micromouseuci/micromouse-kit/README.md

Starting new README for the BluePill Version thats work in progress!
