micromouseuci/micromouse-kit/3d_printed_parts/Motor Offset.SLDPRT

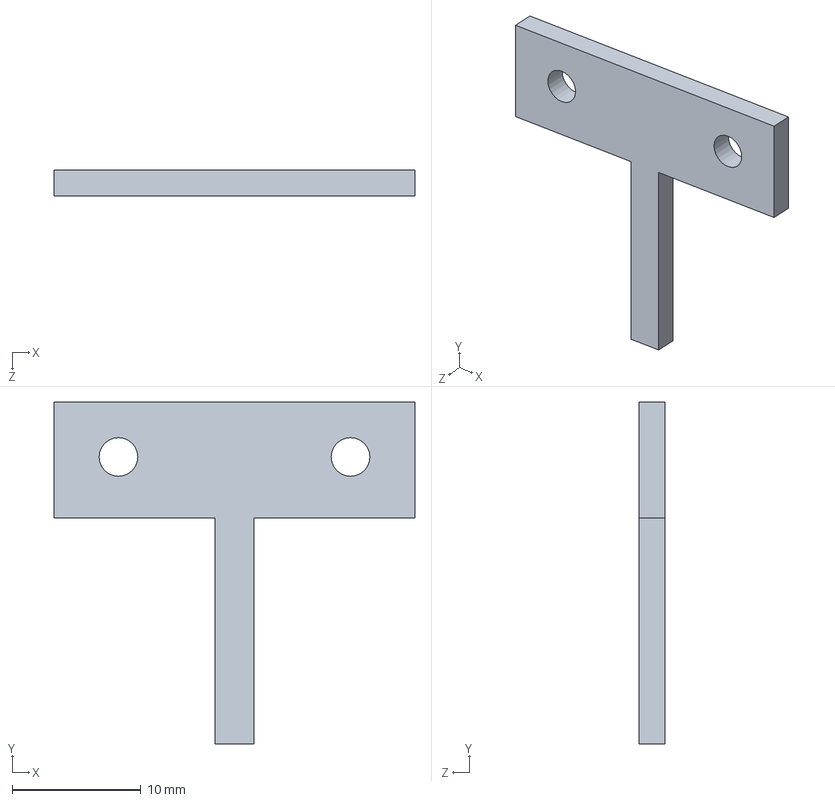
[picture p1: CAD file, 2021-07-19]
3d_printed_parts/Motor Offset.SLDPRT
28.0 x 26.5 x 2.00 mm
