micromouseuci/micromouse-kit/3d_printed_parts/27 Rubber Band Wheel.SLDPRT

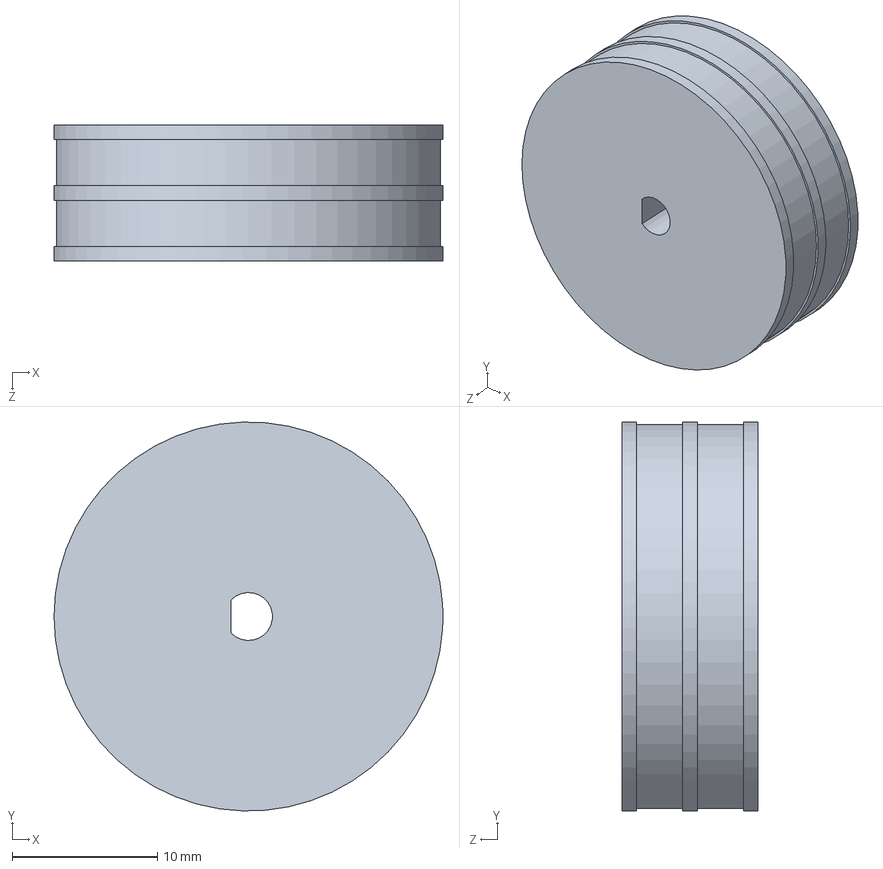
[picture p2: CAD file, 2021-07-19]
3d_printed_parts/27 Rubber Band Wheel.SLDPRT
26.8 x 26.7 x 9.35 mm
