micromouseuci/micromouse-kit/3d_printed_parts/Mouse Skates.SLDPRT

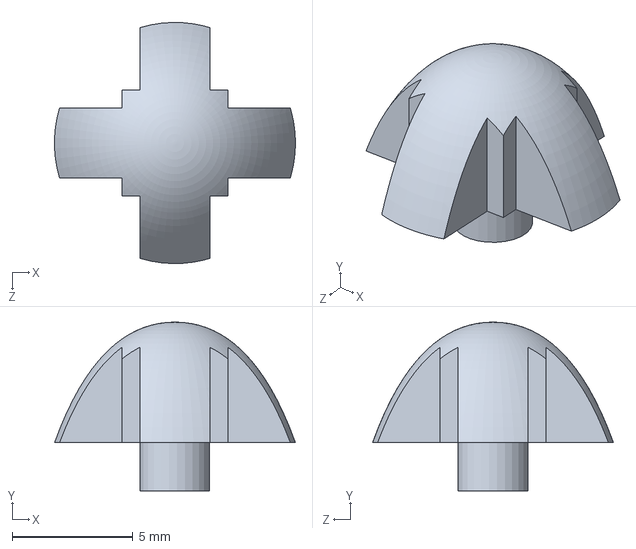
[picture p3: CAD file, 2021-07-19]
3d_printed_parts/Mouse Skates.SLDPRT
10.00 x 7.00 x 10.00 mm
