micromouseuci/micromouse-kit/3d_printed_parts/flat skates.SLDPRT

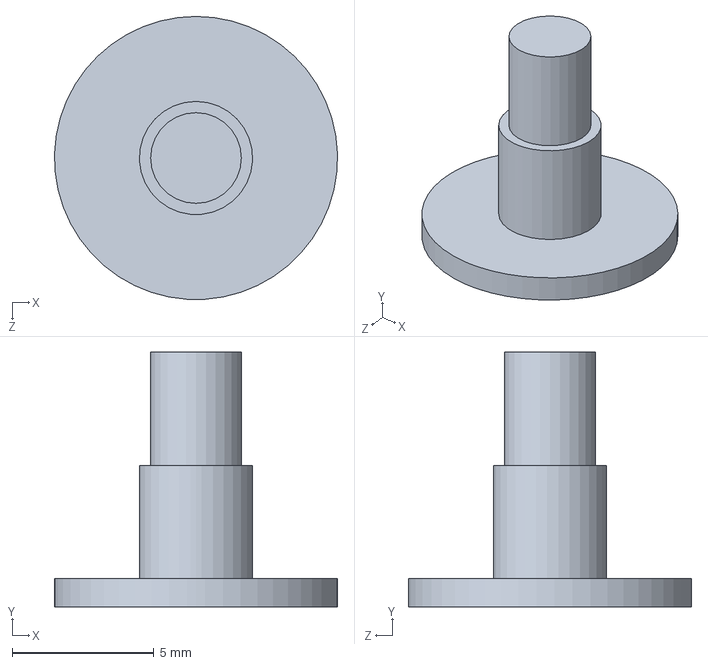
[picture p4: CAD file, 2021-07-19]
3d_printed_parts/flat skates.SLDPRT
9.99 x 9.00 x 10.0 mm
