micromouseuci/micromouse-kit/(list of files, cad)

Other CAD files:
3d_printed_parts/27 Rubber Band Wheel.STL
3d_printed_parts/Mouse Skates.STL
3d_printed_parts/flat skates.STL
