micromouseuci/micromouse-kit/mouse_v2_PAIN copy.kicad_pcb

## KiCad design mouse_v2_PAIN copy.kicad_pcb (2022-06-02, an earlier design)

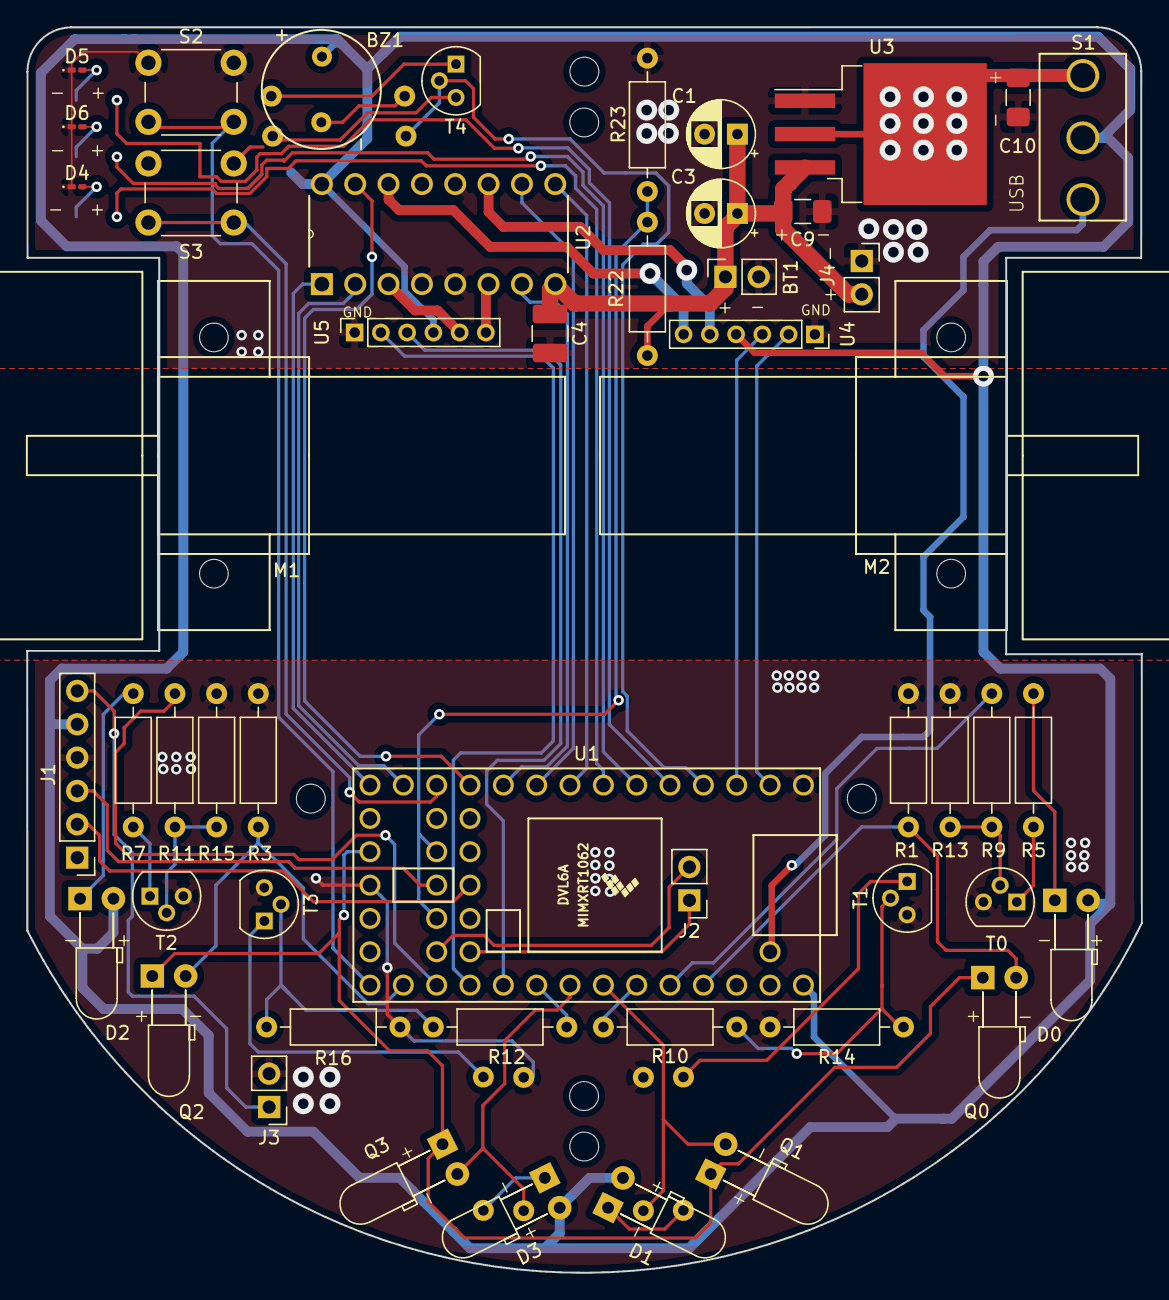
[picture p8: board mouse_v2_PAIN copy.kicad_pcb from above]

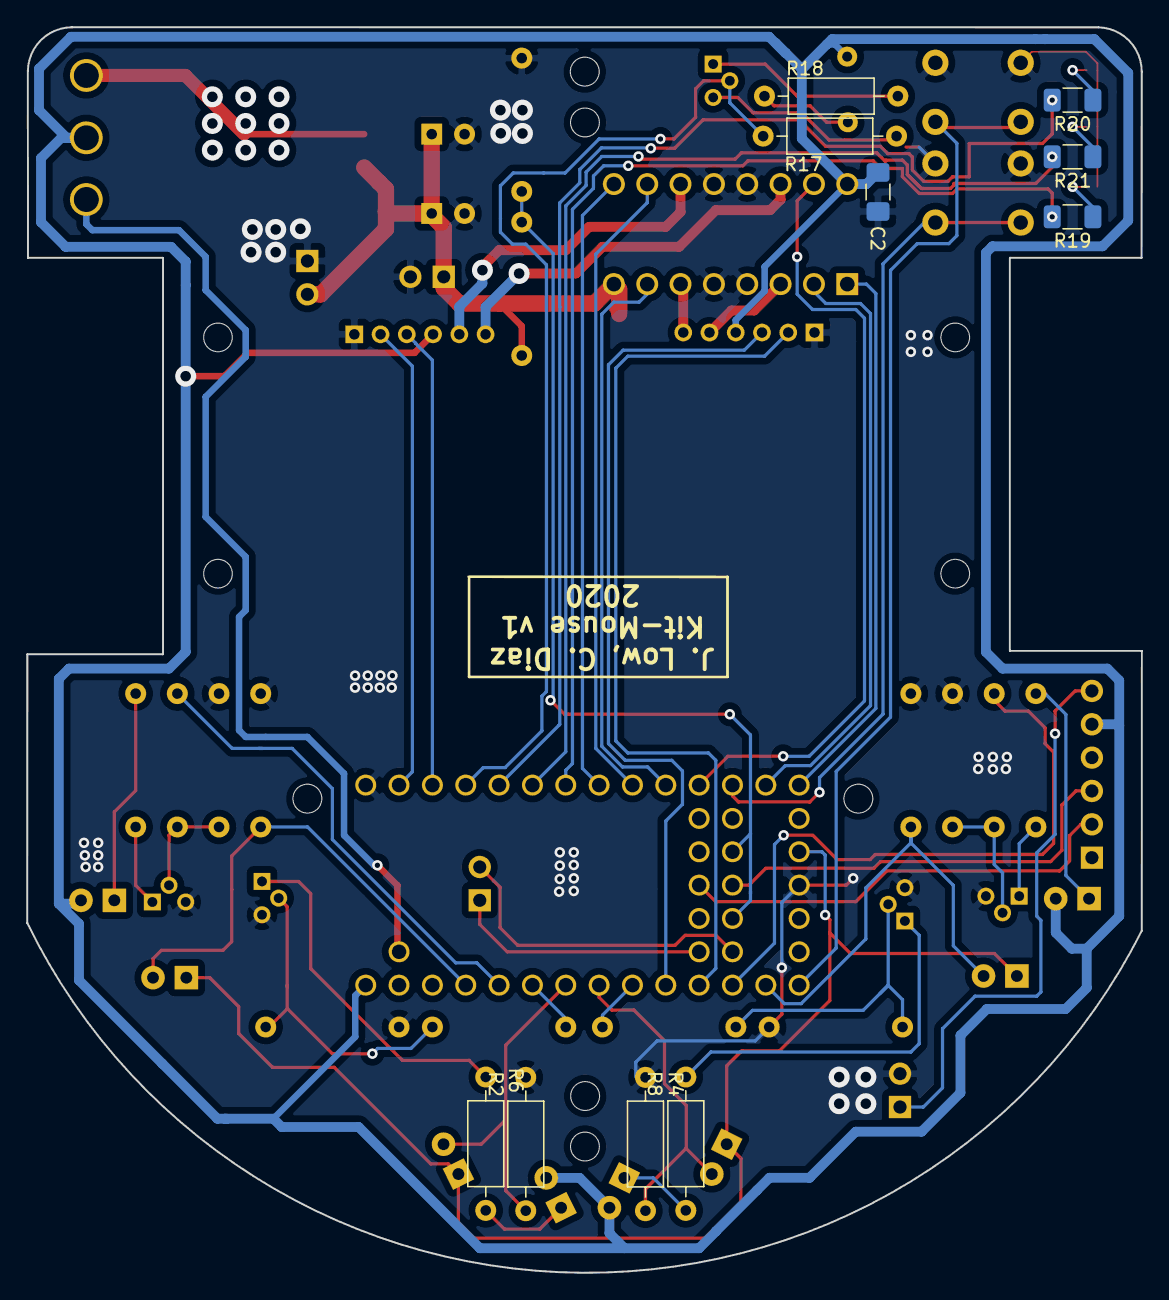
[picture p9: board mouse_v2_PAIN copy.kicad_pcb from below]

Board: 2 copper layers, 84.9 x 94.9 mm, 67 parts (10 on the bottom side), 58 nets.

Parts:
BT1: Battery_Cell; PinSocket_1x02_P2.54mm_Vertical
BZ1: Buzzer; 9x5.5mm Buzzer
C1, C3: 100uF; CP_Radial_D5.0mm_P2.50mm
C2: 0.1uF; C_1206_3216Metric_Pad1.42x1.75mm_HandSolder
C4: 1uF; C_1210_3225Metric_Pad1.42x2.65mm_HandSolder
C9: 10uF; C_1206_3216Metric_Pad1.42x1.75mm_HandSolder
C10: 10uF(Tantalum); C_1206_3216Metric_Pad1.42x1.75mm_HandSolder
D0, D1, D2, D3: SFH4545; LED_D3.0mm_Horizontal_O3.81mm_Z2.0mm
D4, D5, D6: LED; LED_0201_0603Metric_Pad0.64x0.40mm_HandSolder
J1: Conn_01x06_Female; PinHeader_1x06_P2.54mm_Vertical
J2: Conn_01x02_Female; PinHeader_1x02_P2.54mm_Vertical
J3: Conn_01x02_Male; PinHeader_1x02_P2.54mm_Vertical
J4: I2C_Conn; PinSocket_1x02_P2.54mm_Vertical
M1, M2: Motor_DC; Motor_mouse
MH1, MH2: M3; MountingHole_2.2mm_M2
Q0, Q1, Q2, Q3: Q_Photo_NPN; LED_D3.0mm_Horizontal_O3.81mm_Z2.0mm
R1, R2, R3, R4: 1.8k; R_Axial_DIN0207_L6.3mm_D2.5mm_P10.16mm_Horizontal
R5, R6, R7, R8: 35; R_Axial_DIN0207_L6.3mm_D2.5mm_P10.16mm_Horizontal
R9, R10, R11, R12: 1k; R_Axial_DIN0207_L6.3mm_D2.5mm_P10.16mm_Horizontal
R13, R14, R15, R16, R17: 47k; R_Axial_DIN0207_L6.3mm_D2.5mm_P10.16mm_Horizontal
R18, R22, R23: R; R_Axial_DIN0207_L6.3mm_D2.5mm_P10.16mm_Horizontal
R19, R20, R21: R; R_1206_3216Metric_Pad1.30x1.75mm_HandSolder
S1: EG1218; SWITCH_SLIDE_500SSP1S2M2QEA
S2, S3: GPTS203211B; SW_PUSH_6mm
SK1, SK2, SK3, SK4: M3; MountingHole_2.2mm_M2
T0, T1, T2, T3, T4: Q_NMOS_DGS; TN0104(TO-92)v2
U1: Teensy4.0; Teensy40
U2: SN754410NE (Half-Bridge); DIP254P762X508-16
U3: LM1085-5.0; TO-263-3_TabPin2
U4, U5: Encoder_3081; PinSocket_1x06_P2.00mm_Vertical

Connections:
/3.3v: Q0.1, Q1.1, Q2.1, Q3.1, U1.16
/5v: BZ1.1, C2.1, D0.2, D1.2, D2.2, D3.2, J1.5, S1.2, U1.33, U2.16, U4.4, U5.4
/Buzzer: R17.2, T4.2, U1.4
/Emitter_0: R9.2, U1.29
/Emitter_1: R10.2, U1.28
/Emitter_2: R11.2, U1.22
/Emitter_3: R12.2, U1.25
/GND: BT1.2, C1.2, C2.2, C3.2, C4.2, C9.2, C10.2, D4.1, D5.1, D6.1, J1.4, J3.2, J4.1, R1.1, R2.1, R3.1, R4.1, R13.1, R14.1, R15.1, R16.1, R23.2, S2.1, S3.1, T0.3, T1.3, T2.3, T3.3, U1.1, U1.17, U2.4, U2.5, U2.12, U2.13, U3.1, U4.1, U5.1
/HC05_KEY: J1.6, J3.1
/HC05_RX: J1.2, U1.40
/HC05_TX: J1.3, U1.39
/LED_1: R19.2, U1.7
/LED_2: R20.2, U1.5
/LED_3: R21.2, U1.6
/M1_backward: U1.10, U2.7
/M1_encoder_A: U1.24, U5.3
/M1_encoder_B: U1.23, U5.2
/M1_forward: U1.13, U2.2
/M1_speed: U1.14, U2.1
/M2_backward: U1.11, U2.15
/M2_encoder_A: U1.3, U4.3
/M2_encoder_B: U1.2, U4.2
/M2_forward: U1.9, U2.10
/M2_speed: U1.8, U2.9
/OUT1: U2.3, U5.5
/OUT2: U2.6, U5.6
/OUT3: U2.11, U4.5
/OUT4: U2.14, U4.6
/PUSH_SW: S2.2, U1.20
/PUSH_SW2: S3.2, U1.12
/Reciever_0: Q0.2, R1.2, U1.30
/Reciever_1: Q1.2, R2.2, U1.27
/Reciever_2: Q2.2, R3.2, U1.21
/Reciever_3: Q3.2, R4.2, U1.26
/SCL2: J2.2, U1.35
/SDA2: J2.1, U1.36
/VUSB: S1.3, U1.34
/V_METER: R22.2, R23.1, U1.37, U1.41
/vBatt: BT1.1, C1.1, C3.1, C4.1, C9.1, J4.2, R22.1, U2.8, U3.3
unnamed: BZ1.2, R18.1
unnamed: C10.1, S1.1, U3.2
unnamed: D0.1, R5.1
unnamed: D1.1, R6.1
unnamed: D2.1, R7.1
unnamed: D3.1, R8.1
unnamed: D4.2, R19.1
unnamed: D5.2, R20.1
unnamed: D6.2, R21.1
unnamed: R5.2, T0.1
unnamed: R6.2, T1.1
unnamed: R7.2, T2.1
unnamed: R8.2, T3.1
unnamed: R10.1, R14.2, T1.2
unnamed: R11.1, R15.2, T2.2
unnamed: R12.1, R16.2, T3.2
unnamed: R9.1, R13.2, T0.2
unnamed: R17.1, T4.3
unnamed: R18.2, T4.1
