micromouseuci/micromouse-kit/(commit log)

2021-10-17 Add files via upload
    Fixed voltage meter connection from pin 26 to 30. Connection of resistor for buzzer(?)
    [mouse_v2.sch, mouse_v2_PAIN.kicad_pcb]
2021-10-17 Fixed V1 errors
    Connected Buzzer circuit to gnd
    Connected Volt meter to analog pin
2022-06-02 Revert "Add files via upload"
    [mouse_v2.sch, mouse_v2_PAIN.kicad_pcb]
2022-09-17 more shcem updates
    [mouse_v2.sch]
2022-10-21 started work on pcb
    [mouse_v2.sch, mouse_v2_PAIN.kicad_pcb]
2022-10-24 more tracing
    [mouse_v2.sch, mouse_v2_PAIN.kicad_pcb]
2022-11-01 label cleanup
    [mouse_v2_PAIN.kicad_pcb]
2023-01-27 v0 PCB
    [mouse_v2.sch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]
2023-02-01 changes for v0.1 wip
    [mouse_v2.sch, mouse_v2_PAIN.kicad_pcb]
2023-02-07 v0.1 ordered
    [mouse_v2_PAIN-B_Cu.gbl, mouse_v2_PAIN-B_Mask.gbs, mouse_v2_PAIN-B_Paste.gbp, mouse_v2_PAIN-B_SilkS.gbo, mouse_v2_PAIN-Edge_Cuts.gm1, mouse_v2_PAIN-F_Cu.gtl, mouse_v2_PAIN-F_Mask.gts, mouse_v2_PAIN-F_Paste.gtp]
